swappad/darpa-power/BOM/darpa-power-distribution-BOM.xlsx

PART LIST Darpa Power Distribution Board
Boards: | 4
Qty | Value | Device | Package | Parts | Description | Leftover | Order |  | Link
1 |  | JP2E | JP2 | JP1 | JUMPER | 0 | 4
4 |  | LEDSML0805 | SML0805 | LED1, LED2, LED3, LED4 | LED | 0 | 16
0 |  | M251 | M251 | S2 | SLIDING SWITCH | 0 | 0
3 | 100k | R-EU_R0805 | R0805 | R11, R13, R18 | RESISTOR, European symbol | 2 | 10
16 | 100n | C-EUC0805K | C0805K | C2, C4, C6, C8, C10, C13, C14, C16, C18, C20, C22, C24, C26, C28, C30, C32 | CAPACITOR, European symbol | 13 | 51
7 | 10k | R-EU_R0805 | R0805 | R2, R4, R5, R6, R7, R9, R10 | RESISTOR, European symbol | 12 | 16
12 | 10u | CPOL-EUE1.8-4 | E1,8-4 | C1, C5, C15, C17, C19, C21, C23, C25, C27, C29, C31, C33 | POLARIZED CAPACITOR, European symbol | 44 | 4
1 | 150p | C-EUC0805K | C0805K | C11 | CAPACITOR, European symbol | 18 | -14
2 | 1k | R-EU_R0805 | R0805 | R12, R14 | RESISTOR, European symbol | 2 | 6
2 | 200 | R-EU_R0805 | R0805 | R21, R22 | RESISTOR, European symbol | 18 | -10
1 | 20m | R-EU_0613/15 | P0613/15 | R8 | RESISTOR, European symbol | -1 | 5 |  | https://www.mouser.sg/ProductDetail/Welwyn-Components-TT-Electronics/LOB3R020FLF
2 | 22u | CPOL-EUE2.5-6 | E2,5-6 | C9, C12 | POLARIZED CAPACITOR, European symbol | 7 | 1
2 | 3.3u | WE-CHSA_1011_7843330330 | WE-CHSA_1011 | L1, L3 | WE-CHSA SMD High Current Inductor 7843330330/3,3uH | 0 | 8
1 | 15u |  | WE-CHSA_1011 | L2 |  | 0 | 4 |  | https://www.mouser.sg/ProductDetail/KEMET/MPX1D0840L150
3 | 470 | R-EU_R0805 | R0805 | R15, R16, R17 | RESISTOR, European symbol | 5 | 7
1 | 470u | CPOL-EUE7.5-16 | E7,5-16 | C34 | POLARIZED CAPACITOR, European symbol | 4 | 0
2 | 47u | CPOL-EUE2.5-6 | E2,5-6 | C3, C7 | POLARIZED CAPACITOR, European symbol | 7 | 1
1 | 5.23k | R-EU_R0805 | R0805 | R19 | RESISTOR, European symbol | 2 | 2
1 | 54.9k | R-EU_R0805 | R0805 | R1 | RESISTOR, European symbol | 4 | 0
2 | 600 | R-EU_R0805 | R0805 | R20, R23 | RESISTOR, European symbol | 0 | 8
1 | 61300211121 | 61300211121 | 61300211121 | J1 | CONN HEADER VERT 3POS 2.54MM | -1 | 5 |  | https://www.mouser.sg/ProductDetail/TE-Connectivity-AMP/826936-3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
1 | 61300211121 | 61300211121 | 61300211121 | J1 | CONN HEADER VERT 2POS 2.54MM | 0 | 4 |  | https://www.mouser.sg/ProductDetail/Molex/22-28-4027
1 | 68.1k | R-EU_R0805 | R0805 | R3 | RESISTOR, European symbol | 19 | -15
1 | BAS40 | BAS40 | SOT23 | D1 | Silicon Schottky Diodes | 3 | 1
3 | BSS123 | BSS123 | SOT23 | Q4, Q5, Q6 | N-CHANNEL MOS FET | 7 | 5
3 | IRFR5305 | IRFR5305 | D-PAK_TO252AA | Q1, Q2, Q3 | HEXFET Power MOSFET | 3 | 9
1 | LTC2945 | LTC2945 | LTC2945 | U$3 |  | 0 | 4
12 | MKDSN1,5/2-5,08 | MKDSN1,5/2-5,08 | MKDSN1,5/2-5,08 | X1, X2, X3, X4, X5, X6, X7, X8, X9, X10, X11, X12 | MKDSN 1,5/ 2-5,08 Printklemme | 3 | 45
1 | SWS004 | SWS004 | SMS-004 | S1 | SMD Dip Switch 4 pol. | -1 | 5 |  | https://www.mouser.sg/ProductDetail/Omron-Electronics/A6S-4104-H
1 | TPS54302 | TPS54302 | SOT23-6 | U$5 |  | 1 | 3
2 | TPS565208 | TPS565208 | SOT23-6 | U$1, U$2 |  | 2 | 6
1 | XT60 | XT60 | XT60 | U$4 | XT60 | x | #VALUE! | not sure how many we have!!
