swappad/darpa-power/darpa-power-distribution.dxf

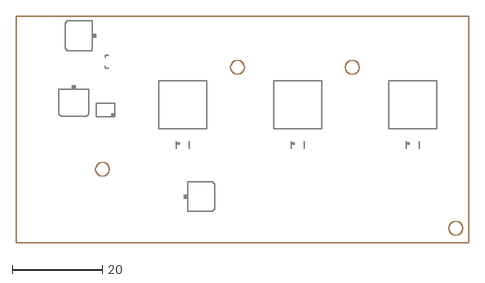
[picture p1: CAD file, 2020-01-10]
darpa-power-distribution.dxf
100.0 x 50.0
