swappad/darpa-power/documentation/schematic1.pdf

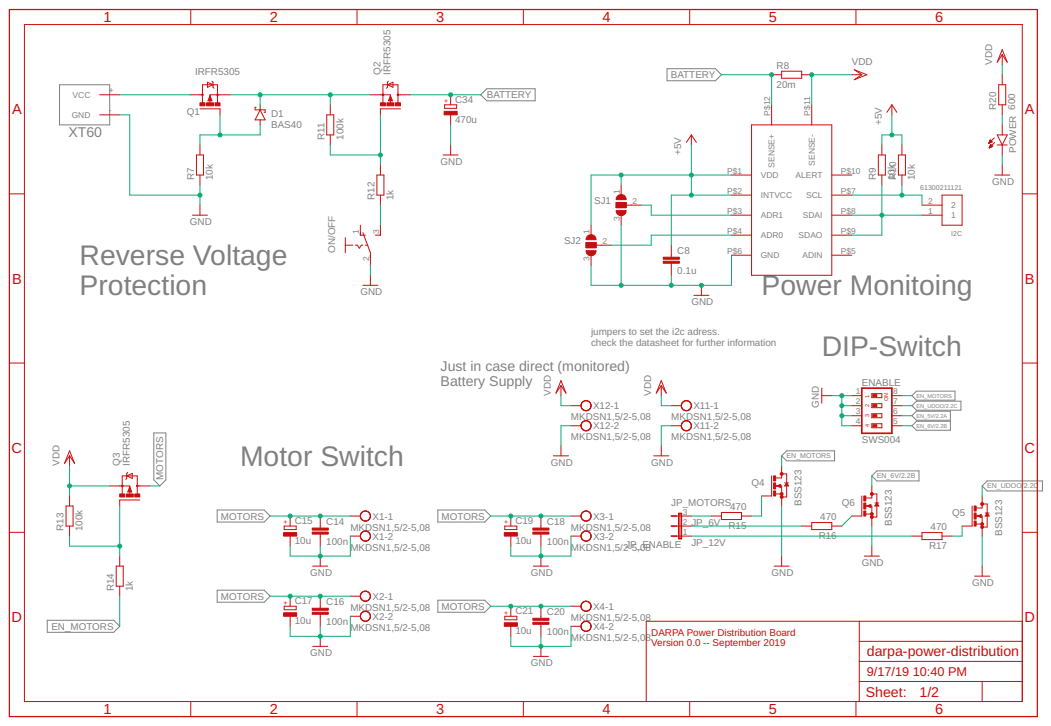
[picture p2: page 1]

SENSE+ P$12 SENSE- P$11 ALERT P$10 SCL P$7 SDAI P$8 SDAO

jumpers to set the i2c adress. check the datasheet for further information Reverse Voltage
Protection

Just in case direct (monitored)
Battery Supply

DARPA Power Distribution Board Version 0.0 -- September 2019
