swappad/darpa-power/documentation/parts-bottom.pdf

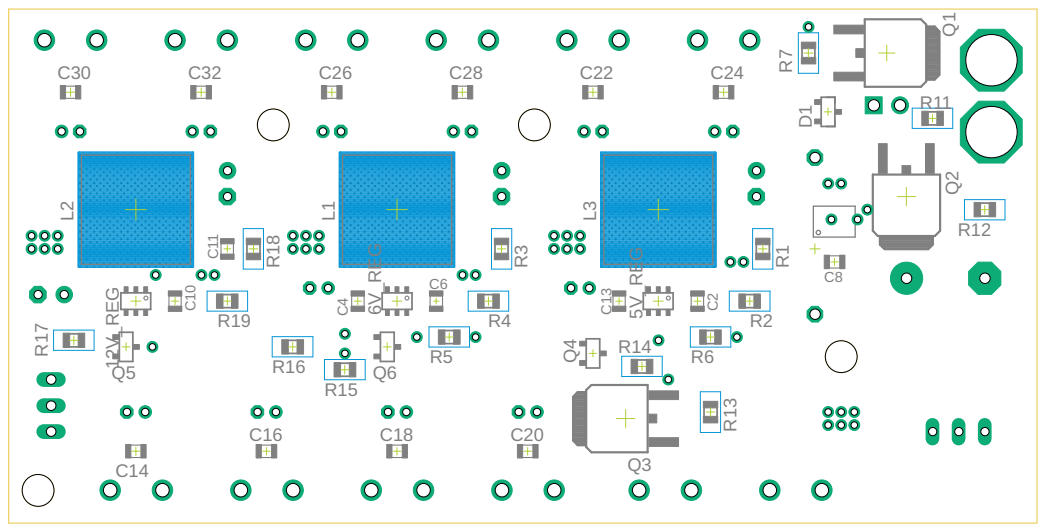
[picture p3: page 1]
