swappad/darpa-power/documentation/parts-top.pdf

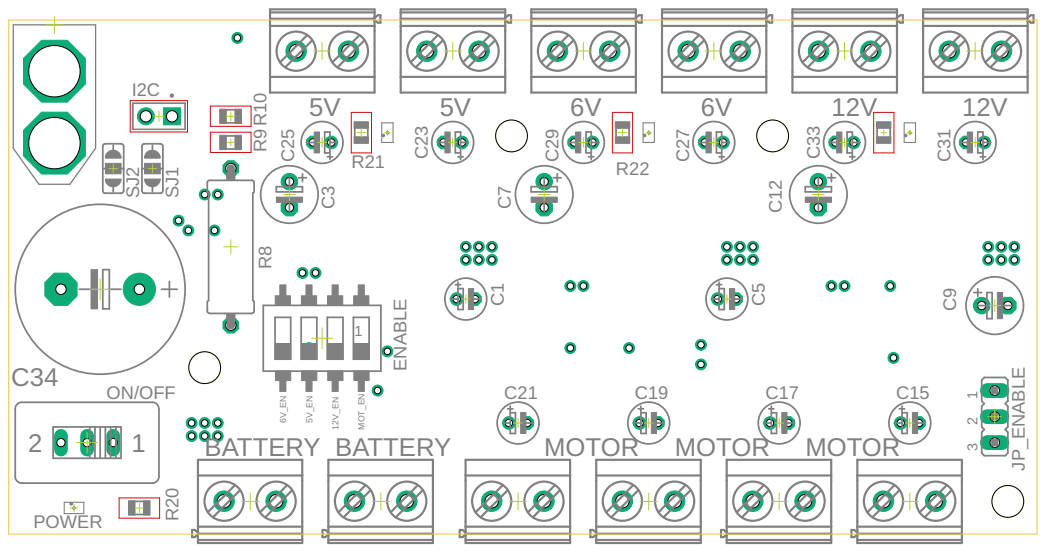
[picture p4: page 1]
