swappad/darpa-power/documentation/schematic2.pdf

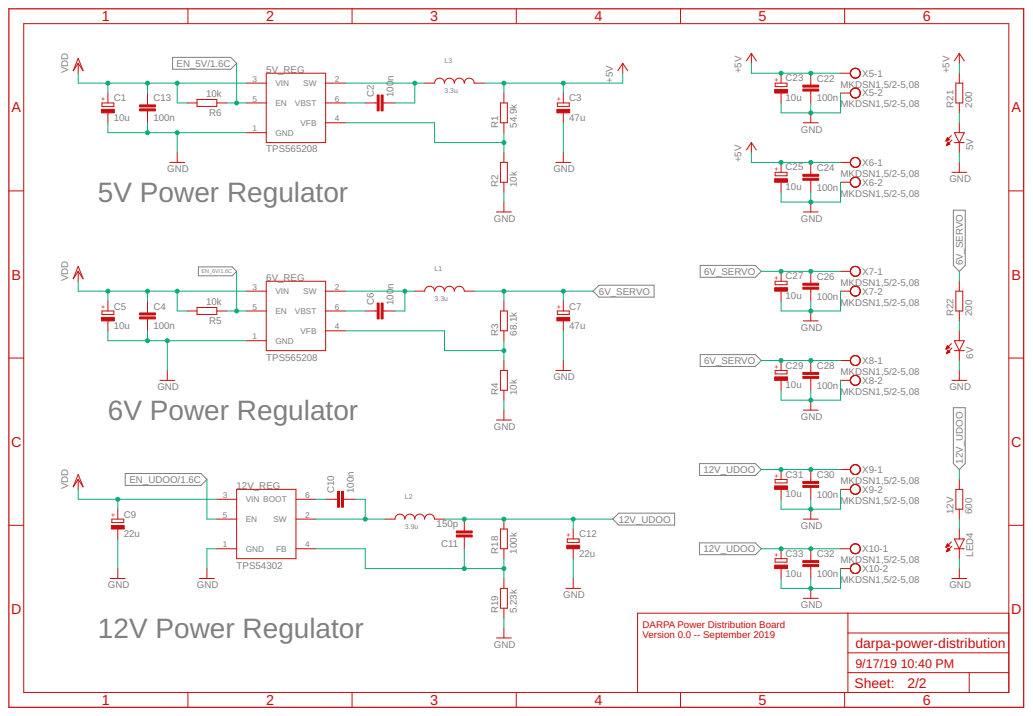
[picture p5: page 1]
