swappad/darpa-power/darpa-power-distribution.brd

## EAGLE design darpa-power-distribution.brd (2019-09-17)

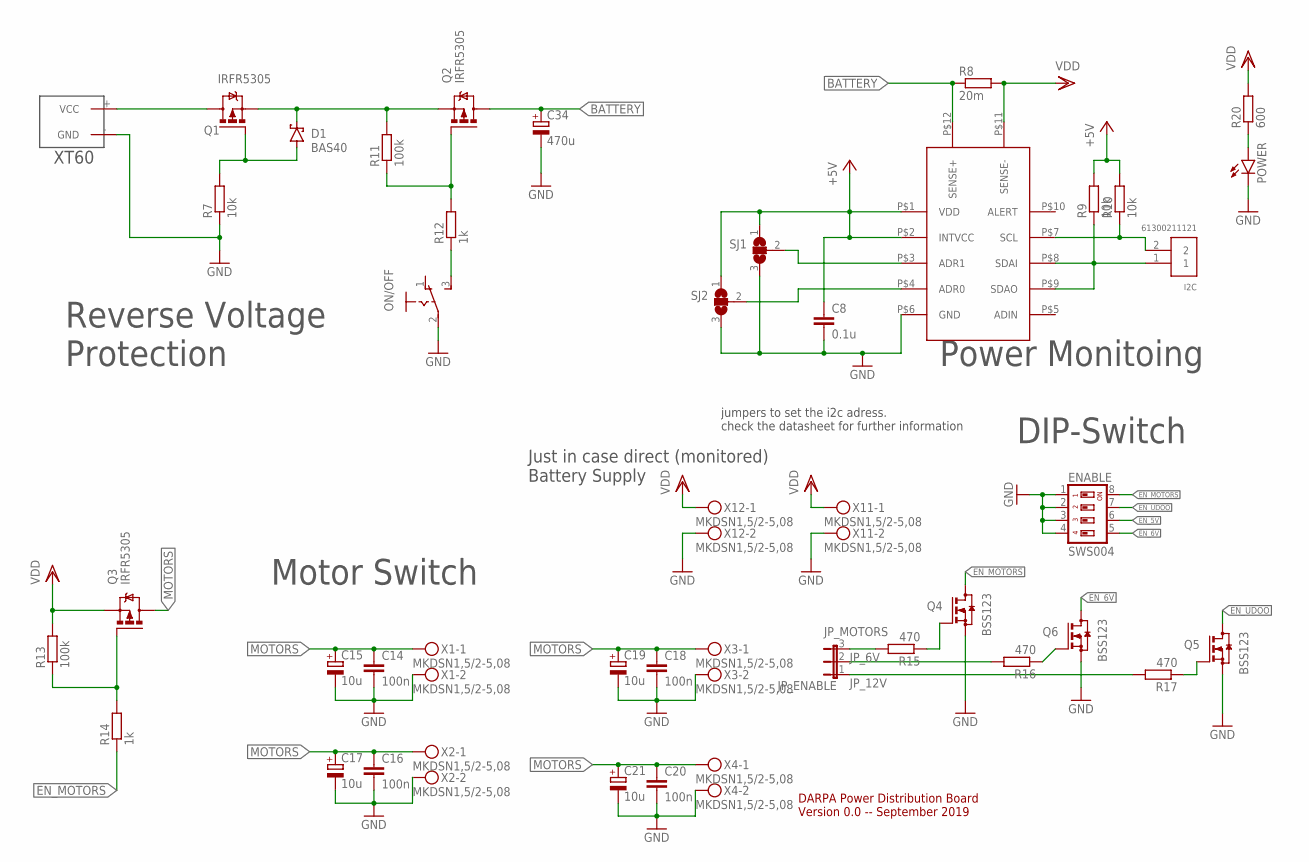
[picture p6: schematic darpa-power-distribution.sch, sheet 1]

Parts:
C8: 0.1u; C0805K
C14, C16, C18, C20: 100n; C0805K
C15, C17, C19, C21: 10u; E1,8-4
C34: 470u; E7,5-16
D1: BAS40; SOT23
ENABLE: SWS004; SMS-004
I2C: 61300211121
JP_ENABLE: JP2E; JP2
ON/OFF: M251
POWER: LEDSML0805; SML0805
Q1, Q2, Q3: IRFR5305; D-PAK_TO252AA
Q4, Q5, Q6: BSS123; SOT23
R7, R9, R10: 10k; R0805
R8: 20m; P0613/15
R11, R13: 100k; R0805
R12, R14: 1k; R0805
R15, R16, R17: 470; R0805
R20: 600; R0805
SJ1, SJ2: SJ2W; SJ_2
U$3: LTC2945
U$4: XT60
X1, X2, X3, X4, X11, X12: MKDSN1,5/2-5,08

Connections:
+5V: C8.1, R9.2, R10.2, SJ1.1, SJ2.1, U$3.P$1 (VDD), U$3.P$2 (INTVCC); also elsewhere on the board
BATTERY: C34.+, Q2.4 (D), R8.1, U$3.P$12 (SENSE+)
EN_5V: ENABLE.6; also elsewhere on the board
EN_6V: ENABLE.5, Q6.3 (D); also elsewhere on the board
EN_MOTORS: ENABLE.8, Q4.3 (D), R14.1
EN_UDOO: ENABLE.7, Q5.3 (D); also elsewhere on the board
GND: C8.2, C14.2, C15.-, C16.2, C17.-, C18.2, C19.-, C20.2, C21.-, C34.-, ENABLE.1, ENABLE.2, ENABLE.3, ENABLE.4, ON/OFF.2, POWER.C, Q4.2 (S), Q5.2 (S), Q6.2 (S), R7.1, SJ1.3, SJ2.3, U$3.P$6 (GND), U$4.- (GND), X1.2, X2.2, X3.2, X4.2, X11.2, X12.2; also elsewhere on the board
JP_6V: JP_ENABLE.2, R16.2
JP_12V: JP_ENABLE.1, R17.2
JP_MOTORS: JP_ENABLE.3, R15.2
MOTORS: C14.1, C15.+, C16.1, C17.+, C18.1, C19.+, C20.1, C21.+, Q3.4 (D), X1.1, X2.1, X3.1, X4.1
unnamed: D1.1 (A), Q1.1 (G), R7.2
unnamed: SJ1.2, U$3.P$3 (ADR1)
unnamed: SJ2.2, U$3.P$4 (ADR0)
unnamed: Q2.1 (G), R11.1, R12.2
unnamed: D1.3 (C), Q1.3 (S), Q2.3 (S), R11.2
unnamed: Q3.1 (G), R13.1, R14.2
unnamed: ON/OFF.3 (S), R12.1
unnamed: Q1.4 (D), U$4.+ (VCC)
unnamed: Q5.1 (G), R17.1
unnamed: Q4.1 (G), R15.1
unnamed: Q6.1 (G), R16.1
unnamed: POWER.A, R20.1
SCL: I2C.2, R10.1, U$3.P$7 (SCL)
SDA: I2C.1, R9.1, U$3.P$8 (SDAI), U$3.P$9 (SDAO)
VDD: Q3.3 (S), R8.2, R13.2, R20.2, U$3.P$11 (SENSE-), X11.1, X12.1; also elsewhere on the board

Notes on the sheet:
jumpers to set the i2c adress. check the datasheet for further information
Reverse Voltage Protection
Motor Switch
Power Monitoing
DIP-Switch
Just in case direct (monitored) Battery Supply
DARPA Power Distribution Board Version 0.0 -- September 2019

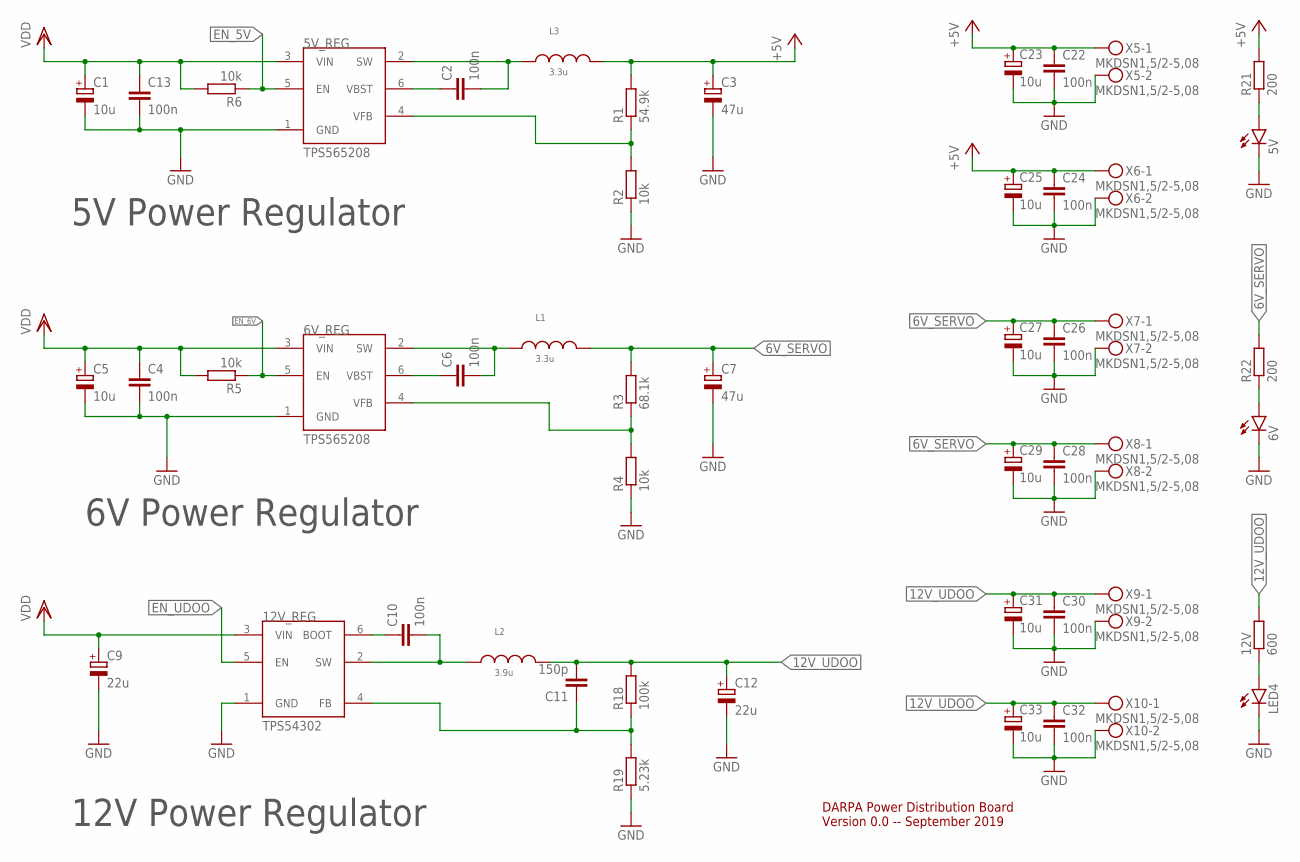
[picture p7: schematic darpa-power-distribution.sch, sheet 2]

Parts:
5V, 6V: LEDSML0805; SML0805
5V_REG, 6V_REG: TPS565208; SOT23-6
12V: 600; R0805
12V_REG: TPS54302; SOT23-6
C1, C5, C23, C25, C27, C29, C31, C33: 10u; E1,8-4
C2, C4, C6, C10, C13, C22, C24, C26, C28, C30, C32: 100n; C0805K
C3, C7: 47u; E2,5-6
C9, C12: 22u; E2,5-6
C11: 150p; C0805K
L1, L3: 3.3u; WE-CHSA_1011
L2: 3.9u; WE-CHSA_1011
LED4: LEDSML0805; SML0805
R1: 54.9k; R0805
R2, R4, R5, R6: 10k; R0805
R3: 68.1k; R0805
R18: 100k; R0805
R19: 5.23k; R0805
R21, R22: 200; R0805
X5, X6, X7, X8, X9, X10: MKDSN1,5/2-5,08

Connections:
6V_SERVO: C7.+, C26.1, C27.+, C28.1, C29.+, L1.2, R3.2, R22.2, X7.1, X8.1
12V_UDOO: 12V.2, C11.2, C12.+, C30.1, C31.+, C32.1, C33.+, L2.2, R18.2, X9.1, X10.1
+5V: C3.+, C22.1, C23.+, C24.1, C25.+, L3.2, R1.2, R21.2, X5.1, X6.1; also elsewhere on the board
EN_5V: 5V_REG.5 (EN), R6.1; also elsewhere on the board
EN_6V: 6V_REG.5 (EN), R5.1; also elsewhere on the board
EN_UDOO: 12V_REG.5 (EN); also elsewhere on the board
GND: 5V.C, 5V_REG.1 (GND), 6V.C, 6V_REG.1 (GND), 12V_REG.1 (GND), C1.-, C3.-, C4.2, C5.-, C7.-, C9.-, C12.-, C13.2, C22.2, C23.-, C24.2, C25.-, C26.2, C27.-, C28.2, C29.-, C30.2, C31.-, C32.2, C33.-, LED4.C, R2.1, R4.1, R19.1, X5.2, X6.2, X7.2, X8.2, X9.2, X10.2; also elsewhere on the board
unnamed: 5V_REG.4 (VFB), R1.1, R2.2
unnamed: 5V_REG.6 (VBST), C2.1
unnamed: 5V_REG.2 (SW), C2.2, L3.1
unnamed: 6V_REG.2 (SW), C6.2, L1.1
unnamed: 6V_REG.6 (VBST), C6.1
unnamed: 6V_REG.4 (VFB), R3.1, R4.2
unnamed: 12V_REG.6 (BOOT), C10.1
unnamed: 12V_REG.2 (SW), C10.2, L2.1
unnamed: 12V_REG.4 (FB), C11.1, R18.1, R19.2
unnamed: 5V.A, R21.1
unnamed: 6V.A, R22.1
unnamed: 12V.1, LED4.A
VDD: 5V_REG.3 (VIN), 6V_REG.3 (VIN), 12V_REG.3 (VIN), C1.+, C4.1, C5.+, C9.+, C13.1, R5.2, R6.2; also elsewhere on the board

Notes on the sheet:
5V Power Regulator
6V Power Regulator
12V Power Regulator
DARPA Power Distribution Board Version 0.0 -- September 2019

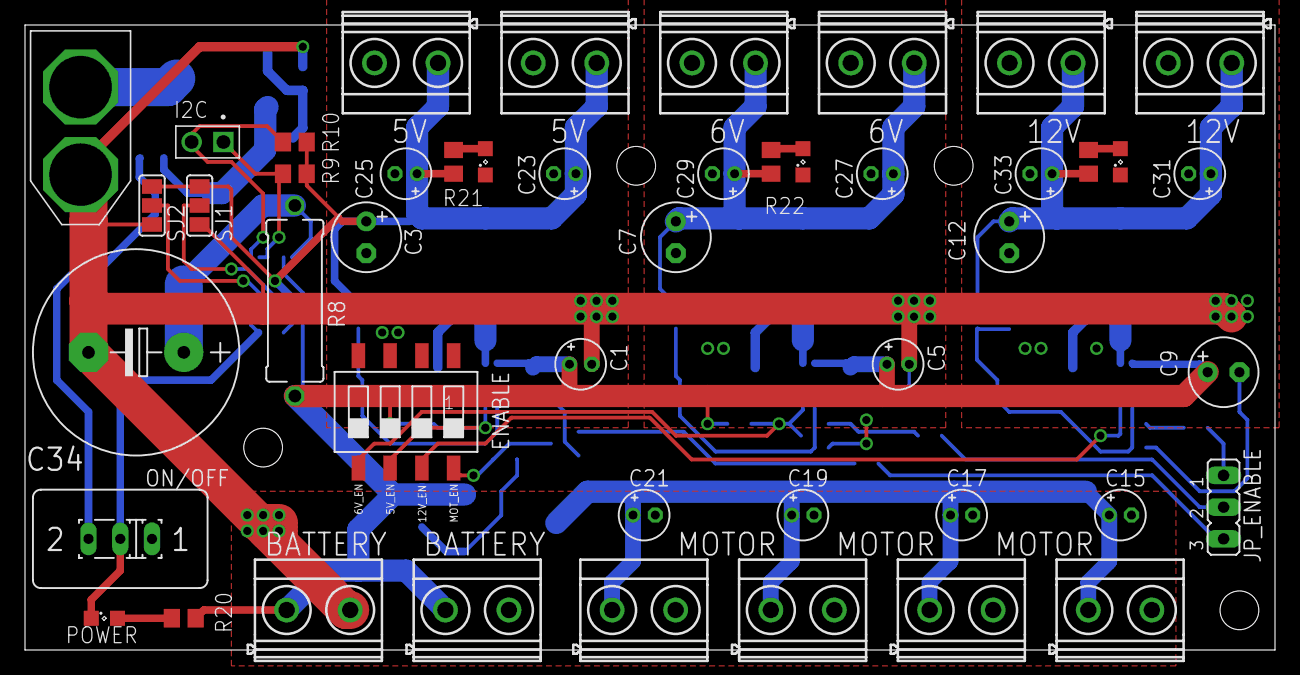
[picture p8: board darpa-power-distribution.brd from above]

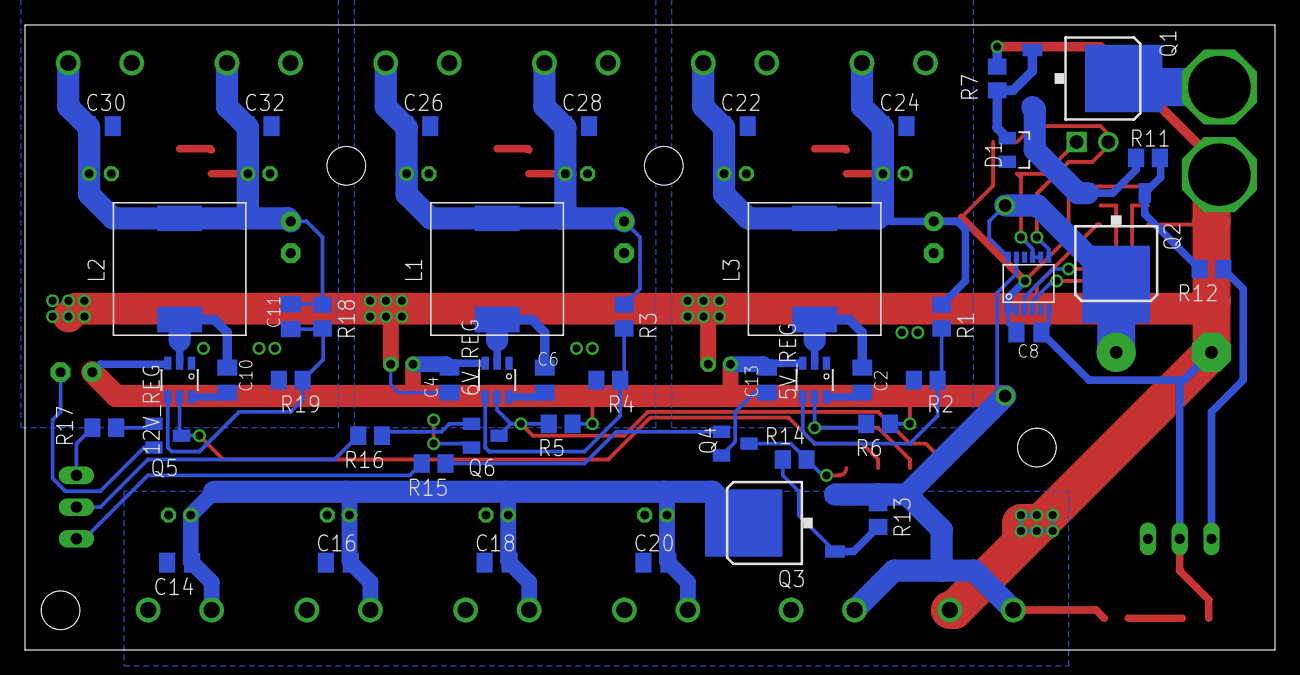
[picture p9: board darpa-power-distribution.brd from below]

Board: 2 copper layers, 100.0 x 50.0 mm, 94 parts (47 on the bottom side), 40 nets.
