swappad/darpa-power/(commit log)

2019-09-05 placing improved. routing proceeded
    [darpa-power-distribution.brd, darpa-power-distribution.sch]
2019-09-07 proceeded routing. changes in positioning
    [darpa-power-distribution.brd]
2019-09-09 proceed routing
    [darpa-power-distribution.brd]
2019-09-09 routing completed; Errors fixed; added LEDs and BOM; TODO: DRC, second cheack and approval
    [darpa-power-distribution-BOM.xlsx, darpa-power-distribution-raw.csv, darpa-power-distribution.brd, darpa-power-distribution.sch]
2019-09-15 corrected typo in resistor value
    [darpa-power-distribution-BOM.xlsx, darpa-power-distribution.brd, darpa-power-distribution.sch]
2019-09-17 placing improved, DRC done, labels aligned
    [darpa-power-distribution.brd, darpa-power-distribution.sch]
2019-09-17 little changes
    [darpa-power-distribution.brd]
2019-10-29 BOM updated for the next order
    [darpa-power-distribution-BOM.xlsx]
2019-12-03 schematics and layout added as pdf
2020-01-10 contours added as .dxf
    [darpa-power-distribution.dxf]
