swappad/darpa-power/(notices)

Notices in the files:
parts and their libraries:
Wurth_Elektronik_Passive_rev19e: Copyright: Würth Elektronik
